EricSFR/ESC-analysis/ESC_Analysis_Schematic.PDF

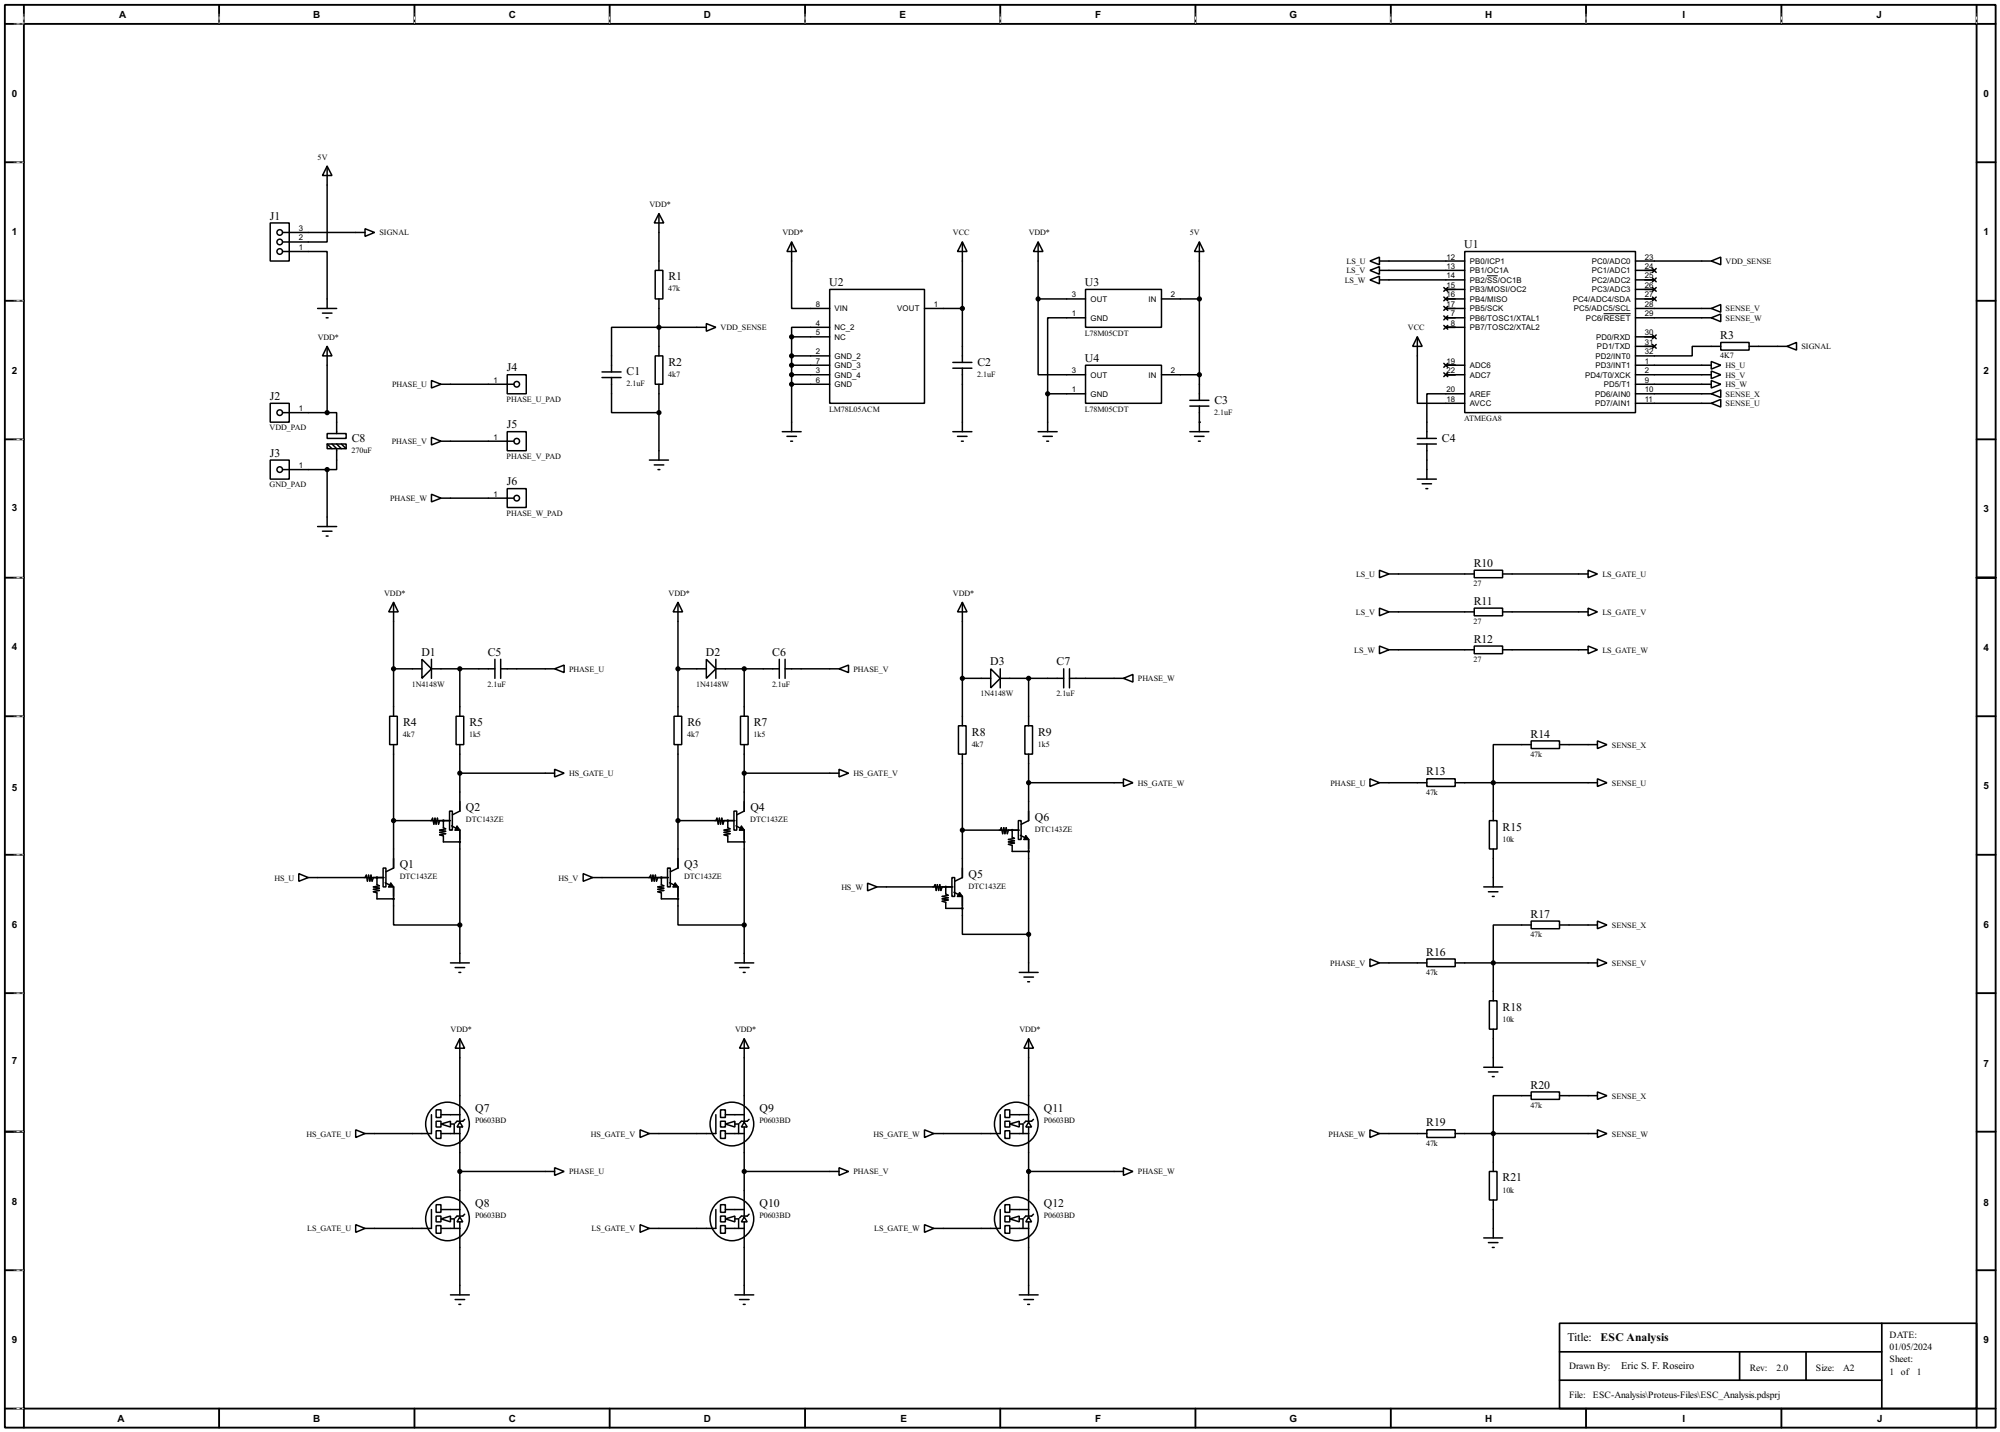
[picture p14: page 1]

File: ESC-Analysis\Proteus-Files\ESC_Analysis.pdsprj
