EricSFR/ESC-analysis/(list of files, drawings)

Other design files:
ESC_Analysis.pdsprj
