EricSFR/ESC-analysis/(commit log)

2024-05-01 Rename Captura de tela 2024-04-30 215650.png to Board-w-Components.png
2024-05-01 Rename Captura de tela 2024-04-30 215639.png to Board-Bottom.png
